jivespark/Custom-keyboard/CAD/CAD model.step

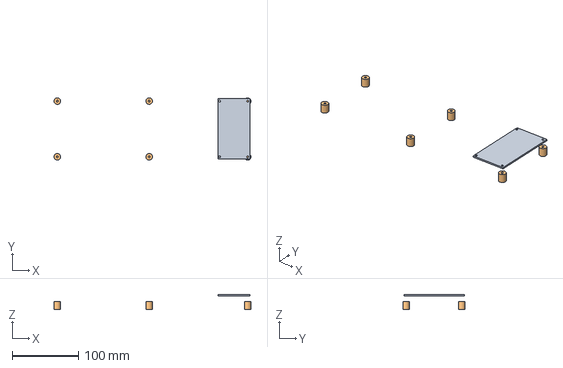
[picture p6: CAD file, 2026-11-12]
CAD/CAD model.step
297.8 x 94.4 x 22.0 mm
