jivespark/Custom-keyboard/CAD/CAD plate.step

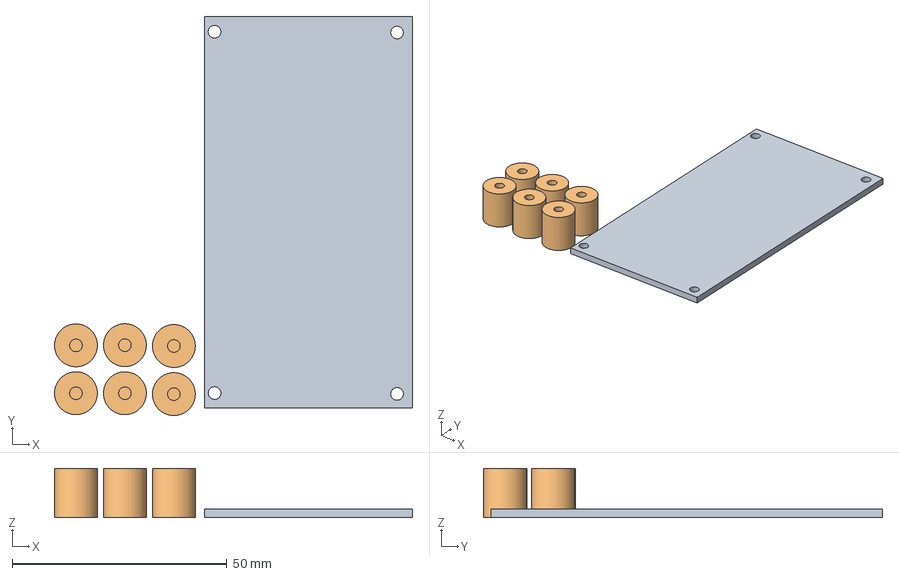
[picture p7: CAD file, 2026-11-12]
CAD/CAD plate.step
83.4 x 93.0 x 11.5 mm
