jivespark/Custom-keyboard/(list of files, cad)

Other CAD files:
CAD/CAD plate.stl
CAD/Cad model.f3d
