jivespark/Custom-keyboard/PCB/Keyboard.kicad_pcb

## KiCad design PCB/Keyboard.kicad_pcb (2026-10-22)

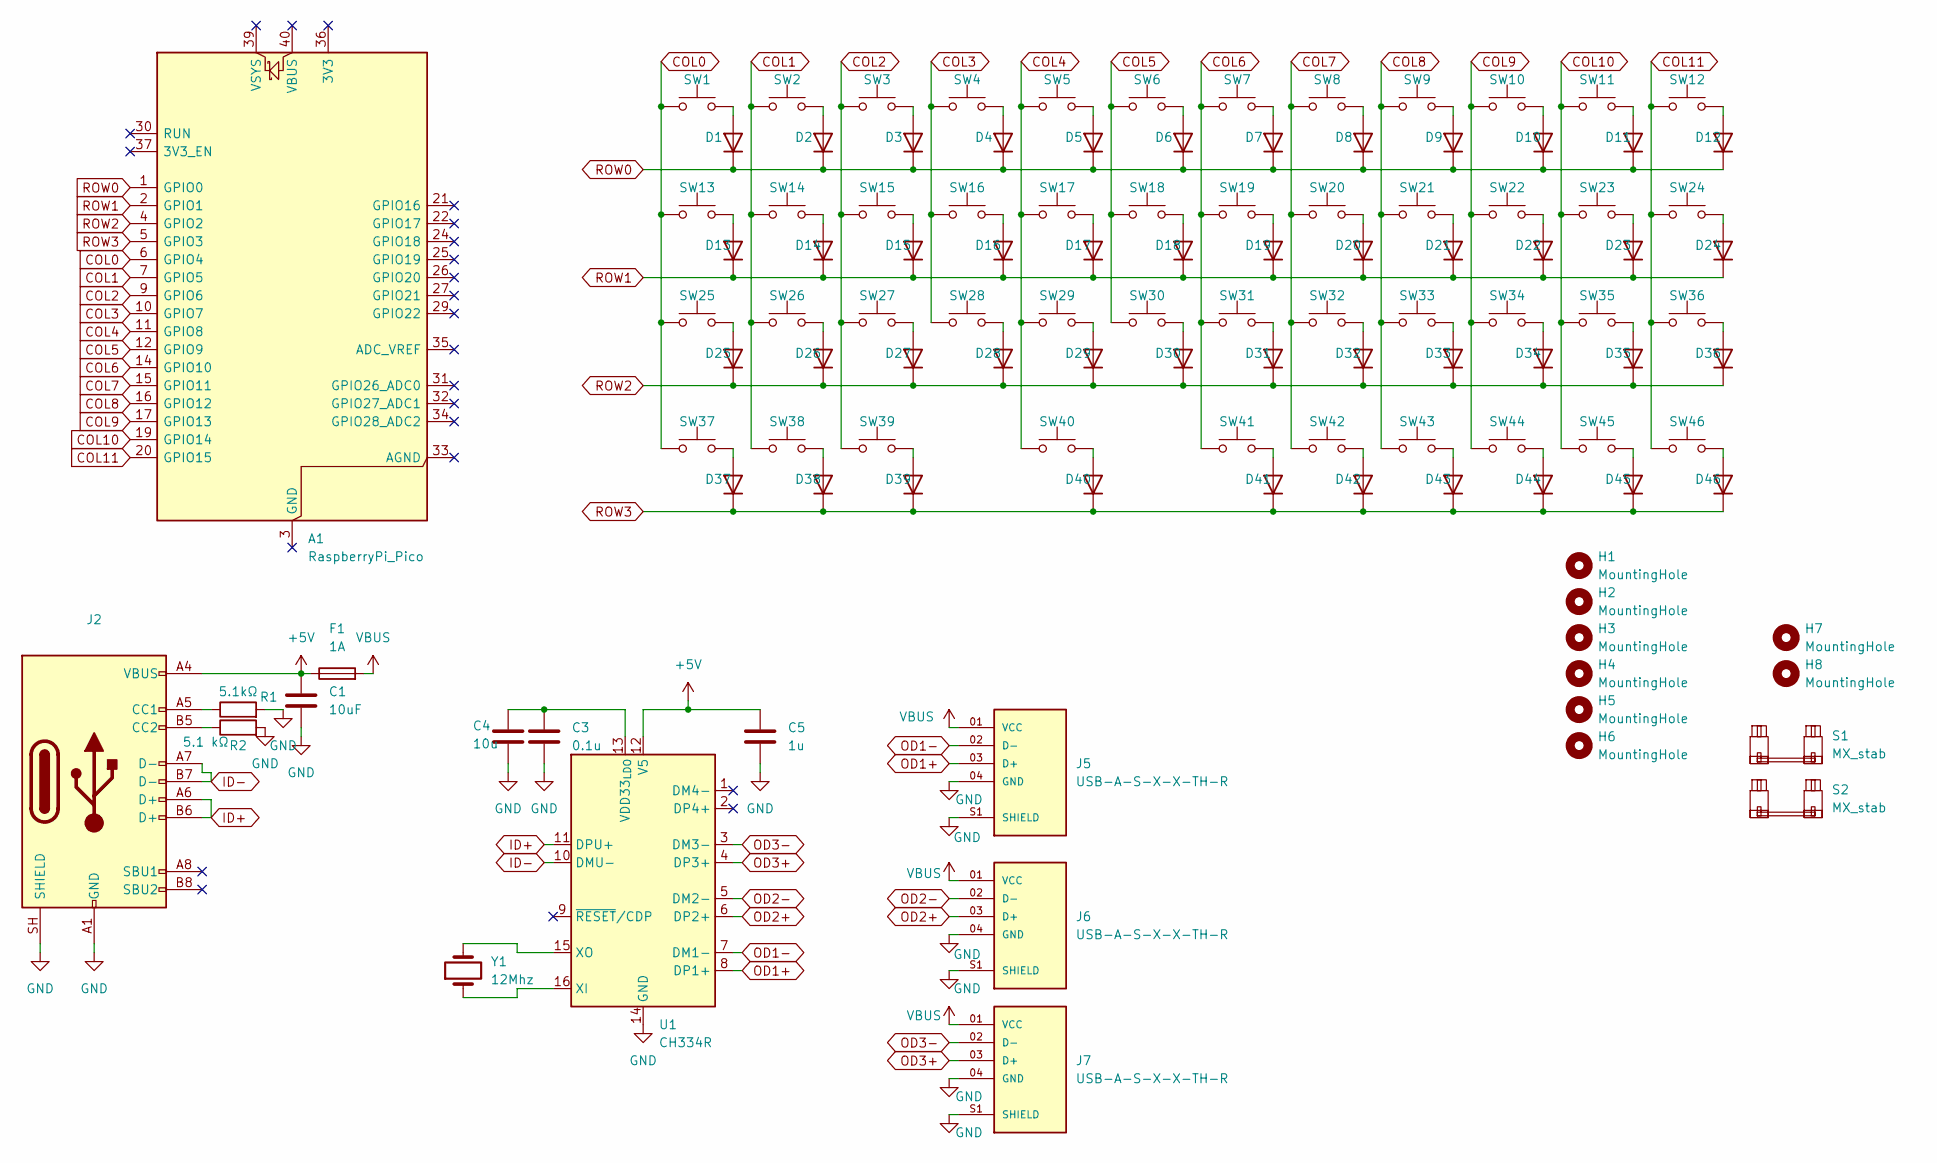
[picture p8: schematic Keyboard.kicad_sch]

Parts:
A1: RaspberryPi_Pico; RaspberryPi_Pico_Common_THT
C1: 10uF; C_0603_1608Metric
C3: 0.1u; C_0603_1608Metric
C4: 10u; C_0603_1608Metric
C5: 1u; C_0603_1608Metric
D1, D2, D3, D4, D5, D6, D7, D8, D9, D10, D11, D12, D13, D14, D15, D16, D17, D18, D19, D20, D21, D22, D23, D24, D25, D26, D27, D28, D29, D30, D31, D32, D33, D34, D35, D36, D37, D38, D39, D40, D41, D42, D43, D44, D45, D46: 1N4148; D_DO-35_SOD27_P7.62mm_Horizontal
F1: 1A; Fuse_1206_3216Metric
H1, H2, H3, H4, H5, H6, H7, H8: MountingHole; MountingHole_3.2mm_M3
J2: USB_C_Receptacle_USB2.0_16P; USB_C_Receptacle_HRO_TYPE-C-31-M-12
J5, J6, J7: USB-A-S-X-X-TH-R; SAMTEC_USB-A-S-X-X-TH-R; PARTREV R
R1: 5.1kΩ; R_0603_1608Metric
R2: 5.1 kΩ; R_0603_1608Metric
S1, S2: MX_stab; STAB_MX_2u
SW1, SW2, SW3, SW4, SW5, SW6, SW7, SW8, SW9, SW10, SW11, SW14, SW15, SW16, SW17, SW18, SW19, SW20, SW21, SW22, SW23, SW26, SW27, SW28, SW29, SW30, SW31, SW32, SW33, SW34, SW35, SW36, SW39, SW40, SW41, SW42, SW43, SW44, SW45, SW46: SW_Push; SW_MX_1u
SW12, SW25: SW_Push; SW_MX_1.75u
SW13, SW38: SW_Push; SW_MX_1.25u
SW24, SW37: SW_Push; SW_MX_1.5u
U1: CH334R; QSOP-16_3.9x4.9mm_P0.635mm
Y1: 12Mhz; Crystal_SMD_3225-4Pin_3.2x2.5mm

Connections:
+5V: C1.1, C5.1, F1.1, J2.A4 (VBUS), J2.A9 (VBUS), J2.B4 (VBUS), J2.B9 (VBUS), U1.12 (V5)
COL0: A1.6 (GPIO4), SW1.1, SW13.1, SW25.1, SW37.1
COL1: A1.7 (GPIO5), SW2.1, SW14.1, SW26.1, SW38.1
COL2: A1.9 (GPIO6), SW3.1, SW15.1, SW27.1, SW39.1
COL3: A1.10 (GPIO7), SW4.1, SW16.1, SW28.1
COL4: A1.11 (GPIO8), SW5.1, SW17.1, SW29.1, SW40.1
COL5: A1.12 (GPIO9), SW6.1, SW18.1, SW30.1
COL6: A1.14 (GPIO10), SW7.1, SW19.1, SW31.1, SW41.1
COL7: A1.15 (GPIO11), SW8.1, SW20.1, SW32.1, SW42.1
COL8: A1.16 (GPIO12), SW9.1, SW21.1, SW33.1, SW43.1
COL9: A1.17 (GPIO13), SW10.1, SW22.1, SW34.1, SW44.1
COL10: A1.19 (GPIO14), SW11.1, SW23.1, SW35.1, SW45.1
COL11: A1.20 (GPIO15), SW12.1, SW24.1, SW36.1, SW46.1
GND: C1.2, C3.2, C4.2, C5.2, J2.A1 (GND), J2.A12 (GND), J2.B1 (GND), J2.B12 (GND), J2.SH (SHIELD), J5.04 (GND), J5.S1 (SHIELD), J5.S2 (SHIELD), J6.04 (GND), J6.S1 (SHIELD), J6.S2 (SHIELD), J7.04 (GND), J7.S1 (SHIELD), J7.S2 (SHIELD), R1.2, R2.2, U1.14 (GND)
ID+: J2.A6 (D+), J2.B6 (D+), U1.11 (DPU+)
ID-: J2.A7 (D-), J2.B7 (D-), U1.10 (DMU-)
unnamed: D1.2 (A), SW1.2
unnamed: D2.2 (A), SW2.2
unnamed: D3.2 (A), SW3.2
unnamed: D4.2 (A), SW4.2
unnamed: D5.2 (A), SW5.2
unnamed: D6.2 (A), SW6.2
unnamed: D7.2 (A), SW7.2
unnamed: D8.2 (A), SW8.2
unnamed: D9.2 (A), SW9.2
unnamed: D10.2 (A), SW10.2
unnamed: D11.2 (A), SW11.2
unnamed: D12.2 (A), SW12.2
unnamed: D13.2 (A), SW13.2
unnamed: D14.2 (A), SW14.2
unnamed: D15.2 (A), SW15.2
unnamed: D16.2 (A), SW16.2
unnamed: D17.2 (A), SW17.2
unnamed: D18.2 (A), SW18.2
unnamed: D19.2 (A), SW19.2
unnamed: D20.2 (A), SW20.2
unnamed: D21.2 (A), SW21.2
unnamed: D22.2 (A), SW22.2
unnamed: D23.2 (A), SW23.2
unnamed: D24.2 (A), SW24.2
unnamed: D25.2 (A), SW25.2
unnamed: D26.2 (A), SW26.2
unnamed: D27.2 (A), SW27.2
unnamed: D28.2 (A), SW28.2
unnamed: D29.2 (A), SW29.2
unnamed: D30.2 (A), SW30.2
unnamed: D31.2 (A), SW31.2
unnamed: D32.2 (A), SW32.2
unnamed: D33.2 (A), SW33.2
unnamed: D34.2 (A), SW34.2
unnamed: D35.2 (A), SW35.2
unnamed: D36.2 (A), SW36.2
unnamed: D37.2 (A), SW37.2
unnamed: D38.2 (A), SW38.2
unnamed: D39.2 (A), SW39.2
unnamed: D40.2 (A), SW40.2
unnamed: D41.2 (A), SW41.2
unnamed: D42.2 (A), SW42.2
unnamed: D43.2 (A), SW43.2
unnamed: D44.2 (A), SW44.2
unnamed: D45.2 (A), SW45.2
unnamed: D46.2 (A), SW46.2
unnamed: J2.A5 (CC1), R1.1
unnamed: J2.B5 (CC2), R2.1
unnamed: C3.1, C4.1, U1.13 (VDD33_{LDO})
unnamed: U1.16 (XI), Y1.1
unnamed: U1.15 (XO), Y1.2
OD1+: J5.03 (D+), U1.8 (DP1+)
OD1-: J5.02 (D-), U1.7 (DM1-)
OD2+: J6.03 (D+), U1.6 (DP2+)
OD2-: J6.02 (D-), U1.5 (DM2-)
OD3+: J7.03 (D+), U1.4 (DP3+)
OD3-: J7.02 (D-), U1.3 (DM3-)
ROW0: A1.1 (GPIO0), D1.1 (K), D2.1 (K), D3.1 (K), D4.1 (K), D5.1 (K), D6.1 (K), D7.1 (K), D8.1 (K), D9.1 (K), D10.1 (K), D11.1 (K), D12.1 (K)
ROW1: A1.2 (GPIO1), D13.1 (K), D14.1 (K), D15.1 (K), D16.1 (K), D17.1 (K), D18.1 (K), D19.1 (K), D20.1 (K), D21.1 (K), D22.1 (K), D23.1 (K), D24.1 (K)
ROW2: A1.4 (GPIO2), D25.1 (K), D26.1 (K), D27.1 (K), D28.1 (K), D29.1 (K), D30.1 (K), D31.1 (K), D32.1 (K), D33.1 (K), D34.1 (K), D35.1 (K), D36.1 (K)
ROW3: A1.5 (GPIO3), D37.1 (K), D38.1 (K), D39.1 (K), D40.1 (K), D41.1 (K), D42.1 (K), D43.1 (K), D44.1 (K), D45.1 (K), D46.1 (K)
VBUS: F1.2, J5.01 (VCC), J6.01 (VCC), J7.01 (VCC)

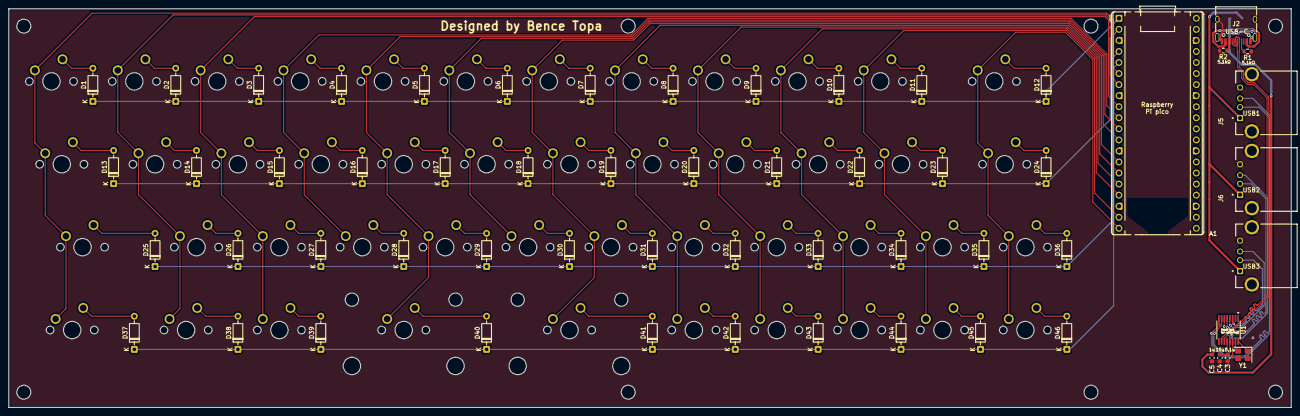
[picture p9: board Keyboard.kicad_pcb from above]

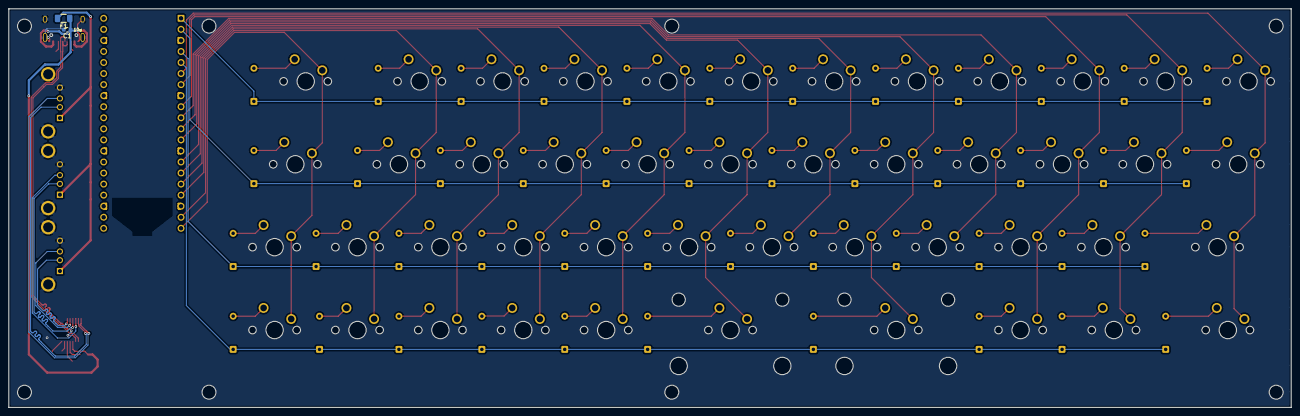
[picture p10: board Keyboard.kicad_pcb from below]

Board: 2 copper layers, 294.7 x 91.6 mm, 116 parts (2 on the bottom side), 78 nets.
