jivespark/Custom-keyboard/JOURNAL.md

# Keyboard: devlog

<!-- Generated by Half Life from project cmuut5obn0a7a01smewnzwqbv. Edits here are overwritten on the next sync. -->
<!-- Generated: 2026-10-22T13:40:13.555Z -->

> [!NOTE]
> This devlog is mirrored from [Half Life](https://halflife.hackclub.com) ([open the project](https://halflife.hackclub.com/projects/cmuut5obn0a7a01smewnzwqbv)). Editing it here will not change the platform's copy, and the next sync overwrites this file.

> A custom 40% layout mechanical keyboard, built with the help of the tutorial from the HackClub ysws keeb. It also has a custom USB hub built in.

| Week | Tier | Hours logged | Entries |
| --- | --- | --- | --- |
| Week 1 | Tier 3 | 27.15h | 12 |

## Contents

1. [2026-10-05: I started designing the schematic. It was honestly pretty easy, in the beginning I had some problems with importing footprints, but after I solved that, everything came together nicely. It was basical](#2026-10-05-i-started-designing-the-schematic-it-was-honestly)
2. [2026-10-05: I finished the schematic, and did the PCB. I added a rotary encoder to my schematic, nothing really special about that, here is how the schematic changed:](#2026-10-05-i-finished-the-schematic-and-did-the-pcb-i-added-)
3. [2026-10-06: I wired everything, for the PCB. It was honestly pretty boring, aside from the row and collum wires, which were pretty satisfying to wire. The rest was just connecting the diodes to the keys. Here is](#2026-10-06-i-wired-everything-for-the-pcb-it-was-honestly-pr)
4. [2026-10-08: So.....](#2026-10-08-so)
5. [2026-10-09: I did the whole PCB today. What I mean is I did the layout and the wiring. This isn't the end of the PCB design though, since I'm planning to do some cool silkscreen at the back. The layout was pretty](#2026-10-09-i-did-the-whole-pcb-today-what-i-mean-is-i-did-th)
6. [2026-10-10: I did some silkscreen design. I tried making a cherry blossom design on the bottom, which I spent around 1,5 hour drawing on my Ipad, and I made this:](#2026-10-10-i-did-some-silkscreen-design-i-tried-making-a-che)
7. [2026-10-10: I did the firmware for the project. I was honestly a bit worried about the firmware, not sure if I could get it done properly, but the actual difficulty wasn't actually bad at all. I used RMK, and I d](#2026-10-10-i-did-the-firmware-for-the-project-i-was-honestly)
8. [2026-10-11: Built a CAD model for the keyboard. I mainly just exported the PCB from KiCad, so that was pretty straightforward. The only really more complicated part was doing the part of the design I'll print. I](#2026-10-11-built-a-cad-model-for-the-keyboard-i-mainly-just-)
9. [2026-10-11: I had done the BOM, and wrote the README, and uploaded files. First I did the BOM. I had to move the project into tier 2 since I had the hours, and needed the extra cost cap, and in the end I ended up](#2026-10-11-i-had-done-the-bom-and-wrote-the-readme-and-uploa)
10. [2026-10-21: So, I got my project sent back. It was said that I copied the tutorial too much, and I didn’t add anything special, which I didn’t realize at first but now that it’s pointed out, I think it is fair, s](#2026-10-21-so-i-got-my-project-sent-back-it-was-said-that-i-)
11. [2026-10-21: In this session I did the PCB.  I made both the layout, and the wiring in one session, since I don't have too much time, and I will also have to do this weeks project still. I realized that with somet](#2026-10-21-in-this-session-i-did-the-pcb-i-made-both-the-lay)
12. [2026-10-22: I finished this project. I first did the CAD work, that was mainly just updating the existing files, since the board outline, and screw placements have changed a little, but I did that.](#2026-10-22-i-finished-this-project-i-first-did-the-cad-work-)

## Design

### 2026-10-05: I started designing the schematic. It was honestly pretty easy, in the beginning I had some problems with importing footprints, but after I solved that, everything came together nicely. It was basical

**1.2h**

I started designing the schematic. It was honestly pretty easy, in the beginning I had some problems with importing footprints, but after I solved that, everything came together nicely. It was basically just placing the same switch-diode combo over and over again. This is how the finished schematic turned out:

Schematic

[Timelapse](https://lookout.hackclub.com/api/media/27c6d5a7-df52-4d46-b883-fdbc42ebd75f/video.mp4)

### 2026-10-05: I finished the schematic, and did the PCB. I added a rotary encoder to my schematic, nothing really special about that, here is how the schematic changed:

**2.93h**

I finished the schematic, and did the PCB. I added a rotary encoder to my schematic, nothing really special about that, here is how the schematic changed:

Encoder

I also did the layout for the PCB. I used a standard 60% ANSI layout, with the pico on the side.

PCB layout

[Timelapse](https://lookout.hackclub.com/api/media/e68e88a8-2046-4165-bb95-594c54f621fd/video.mp4)

### 2026-10-06: I wired everything, for the PCB. It was honestly pretty boring, aside from the row and collum wires, which were pretty satisfying to wire. The rest was just connecting the diodes to the keys. Here is

**1.02h**

I wired everything, for the PCB. It was honestly pretty boring, aside from the row and collum wires, which were pretty satisfying to wire. The rest was just connecting the diodes to the keys. Here is the finished wiring:

wiring

[Timelapse](https://lookout.hackclub.com/api/media/0cb4e7a3-467f-4908-9d13-2f7d27065ac6/video.mp4)

### 2026-10-08: So.....

**2h**

So.....
I am writing this devlog, because my internet is super unstable, and I couldn't get lapse to work properly, thats why I didn't upload a timelapse. I had run into a large problem, since I somehow losst my project files. I don't know what happened, but when I went in to start working on my project I found half of my KiCad files gone, so I had to restart from 0(since the remaining files didn't include the schematic or PCB files). That was pretty bad, but I thought that if I have to restart, maybe I should do something interesting now that I know more about keyboards. So I decided that insted of a regular 60% keyboard I'll try making a 40%. Why the 40%? It is portable, so I can go coding anywhere, and don't have to use my laptops built in keyboard, and I also thought that it looked cute and unique.Here is the main layout I will use(Ill make some modifications to the layout and key sizes, but it will be very similar to this one):

Screenshot from 2026-10-08 16-25-44

I worked on the schematic, nothing too exiting, just a pretty straigthforward key matrix:



And here we are now.

### 2026-10-09: I did the whole PCB today. What I mean is I did the layout and the wiring. This isn't the end of the PCB design though, since I'm planning to do some cool silkscreen at the back. The layout was pretty

**3h**

I did the whole PCB today. What I mean is I did the layout and the wiring. This isn't the end of the PCB design though, since I'm planning to do some cool silkscreen at the back. The layout was pretty straigthforward, ran into quite a bit less problems than last time, and it was cool to  see the layout come together:

Screenshot from 2026-10-09 16-35-00

After that I did the wiring, that was pretty cool too, I always like doing wiring of projects like this, where there are like a bunch of traces going in similar direction:

Screenshot from 2026-10-09 16-55-58

As a finishing touch I imported some CAD models for reference for the switches and stabalizers:

Keyboard

It's looking quite good, I might do another session today, but not sure, hoping to finish this over the weekend.

### 2026-10-10: I did some silkscreen design. I tried making a cherry blossom design on the bottom, which I spent around 1,5 hour drawing on my Ipad, and I made this:

**2h**

I did some silkscreen design. I tried making a cherry blossom design on the bottom, which I spent around 1,5 hour drawing on my Ipad, and I made this:



I tried putting it on the PCB and doing some modifications uding KiCads Image converter, but I couldn't get it to look goood, so in the end I scrapped the idea. Heres how the PCB looked with the silkscreen:

Screenshot from 2026-10-10 13-22-38

I  hope it's okay to log these hours, since I did spend them on the project, but they didn't make the final cut.

### 2026-10-10: I did the firmware for the project. I was honestly a bit worried about the firmware, not sure if I could get it done properly, but the actual difficulty wasn't actually bad at all. I used RMK, and I d

**3h**

I did the firmware for the project. I was honestly a bit worried about the firmware, not sure if I could get it done properly, but the actual difficulty wasn't actually bad at all. I used RMK, and I didn't even have to touch the code itself, it was just a bunch of configuring stuff. I read through the RMK docs, and while it was quite a lot of reading, it was all pretty straigthforward to be honest. I configured the keyboard.toml with my wiring, layout, and keymap, and it mostly did the rest:



After that I had to make the vial.json file for reasons I do not fully understand, but for that I just needed to include my KLE  layout, and that was it. It ended up pretty ugly, so I won't include it, but it will be on the github.

After that was done most of the firmware was ready. One more thing I forgot to mention, is the design process of the layout. The base layer was pretty straigthforward, I tried making it feel as familiar as possible, while making it have all the keys I use frequently.

my-keyboard

The second layer was a bit more interesting, since I had a bit more of a choice over what went in. In the end, I ended up with this layout:

my-keyboard1
The top row has the numbers, for which I varied the order up a bit, with 0 being in front rather than at the end like in most keyboards. The reason I did it like this, since I normally use a hungarian layout keyboard,  which has the 0 in front(not sure why, but all hungarian keyboards have this), so I'm used to that, and it's always weird for me to use english keyboards because of this, so hope this will be better. It also has print screen for taking screenshots, pretty self explanitory.The second row is just the F keys, nothing really special about those. On the third row I have quite a lot of stuff, for example the Undo, Cut, Copy, Paste buttons are there so I can access my most used Control shortcuts with the Fn key too. I also have media controls, for which I usually use a macropad, but with this I can hopefully just use the keyboard. I also have the arrow keys in the corner, perfect place for them I think, since the keys are properly aligned there, and there's no layer shift, so it is natural to use them. I also have the backslash in place of Control, I just didnt have space for it on the base layer, so I put it her.

So that's it for today, and hopefully I can finish this tomorrow!

### 2026-10-11: Built a CAD model for the keyboard. I mainly just exported the PCB from KiCad, so that was pretty straightforward. The only really more complicated part was doing the part of the design I'll print. I

**2h**

Built a CAD model for the keyboard. I mainly just exported the PCB from KiCad, so that was pretty straightforward. The only really more complicated part was doing the part of the design I'll print. I will use some M3x20 screws I have at home, and purchase some M3x10 screws for the feet. The main parts are the feet, and the cover for the pico. The feet are just to keep it suspended, so the pins don't touch my table, and it won't wobble. I also made a little cover for the pico, so it won't show, since the green would ruin the aesthetic. Here's the finished CAD model:


 I also put the parts that will need to be printed into a seperate file to make them easier to print:

Screenshot from 2026-10-11 10-20-44

### 2026-10-11: I had done the BOM, and wrote the README, and uploaded files. First I did the BOM. I had to move the project into tier 2 since I had the hours, and needed the extra cost cap, and in the end I ended up

**2h**

I had done the BOM, and wrote the README, and uploaded files. First I did the BOM. I had to move the project into tier 2 since I had the hours, and needed the extra cost cap, and in the end I ended up with 55 bucks on the BOM. The PCB was the most expensive, by far, since it is a pretty large one. The other stuff I had no problem with. I didn't include the keycaps, since I'll source them differently, and I couldn't find anything good on aliexpress, so I'll pay them out of my own pocket. Here's the finished BOM:

Screenshot from 2026-10-11 11-14-07

I also did the whole github project, uploaded all the files, and made the README. I hope I didn't forget anything, but yeah, now I'm going to try submitting.

Screenshot from 2026-10-11 11-32-15
(This isn't the full README, I just didn't want to include all the ppictures and the BOM)

### 2026-10-21: So, I got my project sent back. It was said that I copied the tutorial too much, and I didn’t add anything special, which I didn’t realize at first but now that it’s pointed out, I think it is fair, s

**2.5h**

So, I got my project sent back. It was said that I copied the tutorial too much, and I didn’t add anything special, which I didn’t realize at first but now that it’s pointed out, I think it is fair, so I’ll try to finish this and resubmit. My idea for this is to make a USB hub included in the keyboard. I researched how I could do this, and I found a chip that does this in a pretty straightforward way. I just had to connect all the ports, and a crystal, and some capacitors. Here is the finished schematic:

Screenshot from 2026-10-20 16-48-04

After that I worked on assigning footprints and finding parts, which probably took up most of my time, since for some reason simple USB connectors were super hard to find. Here is the stuff added to the BOM:

Screenshot from 2026-10-20 16-48-20

I used LCSC for these parts, because it was the cheapest, but considering the shipping costs I might try to find these on aliexpress for free shipping, but stuff is more expensive there, so I’m a bit unsure. Here’s my cart:

Screenshot from 2026-10-20 16-58-10

### 2026-10-21: In this session I did the PCB.  I made both the layout, and the wiring in one session, since I don't have too much time, and I will also have to do this weeks project still. I realized that with somet

**3.5h**

In this session I did the PCB.  I made both the layout, and the wiring in one session, since I don't have too much time, and I will also have to do this weeks project still. I realized that with something unique, this whole USB hub may have gone a bit too far, since it is almost like a whole new project, but I wanted something special, and a bit more electronically complicated, so this is definitely that. For the layout I just wanted to make sure everything that needed to be close, was close, and I also made sure that everything is functional. In the end I ended up on a layout with the ports on the side like a laptop, with the USB-C on top.


(This screenshot also has the wiring because I took it later)

After that I routed everything. I spent quite a bit of time on that, since all the differencial pairs were quite a challange, so I worked a lot on that, and I also made some modifications to the layout halfway through the wiring(not my brightest idea),so I wasted a bit of time on that too. Here is the finished wiring:

Screenshot from 2026-10-21 19-48-35

Screenshot from 2026-10-21 19-48-58
(These might not be too easily understandable, because I also added a ground pour)

Here is the finished PCB:



Also here's the 3D render:



### 2026-10-22: I finished this project. I first did the CAD work, that was mainly just updating the existing files, since the board outline, and screw placements have changed a little, but I did that.

**2h**

I finished this project. I first did the CAD work, that was mainly just updating the existing files, since the board outline, and screw placements have changed a little, but I did that.



After that I did the gerbers, uploaded everything, and updated the readme with the info about the hub. I also reuploded the PCB to JLCPCB, and this PCB ended up 0.5 dollars more expensive, so I had to update the README. Here's the updated README:
