jivespark/Custom-keyboard/(commit log)

2026-10-10 Added CAD models
    [CAD printable.step, Cad model.f3d]
2026-10-11 Uploaded PCB files
    [Keyboard-B_Cu.gbl, Keyboard-B_Mask.gbs, Keyboard-B_Paste.gbp, Keyboard-B_Silkscreen.gbo, Keyboard-Edge_Cuts.gm1, Keyboard-F_Cu.gtl, Keyboard-F_Mask.gts, Keyboard-F_Paste.gtp]
2026-10-11 Added CAD screenshot
2026-10-11 Rename Screenshot 2026-10-11 104643.png to CAD.png
2026-10-11 Rename Screenshot from 2026-10-08 18-05-28.png to Schematic.png
2026-10-11 Rename Screenshot from 2026-10-09 16-55-58.png to PCB.png
2026-10-11 Added BOM
    [BOM.csv]
2026-10-11 Add BOM section to README
2026-10-22 Updated CAD files
    [CAD plate.stl, Cad model.f3d]
2026-10-22 Sync Keyboard from Half Life
    [BOM.csv]
2026-11-12 Updated CAD design files
    Reexported the CAD files, since the project got sent back for not including STEP files
    [CAD model.step, CAD plate.step, CAD plate.stl]
